Roqueloreno/ECC/presepio/3mf/PRESEPIO_v2_LED_placas.png

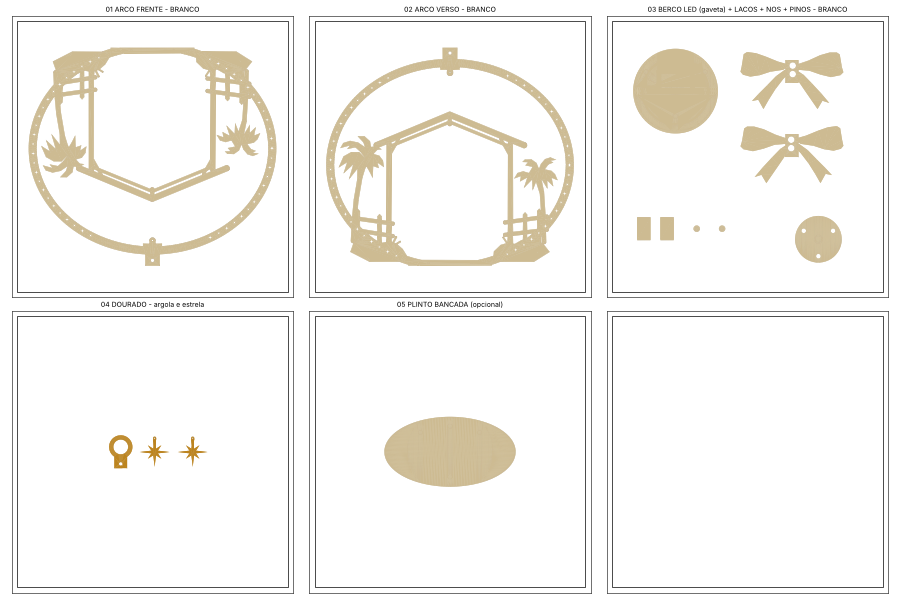
presepio/3mf/PRESEPIO_v2_LED_placas.png
