Roqueloreno/ECC/presepio/img/berco_cortes.png

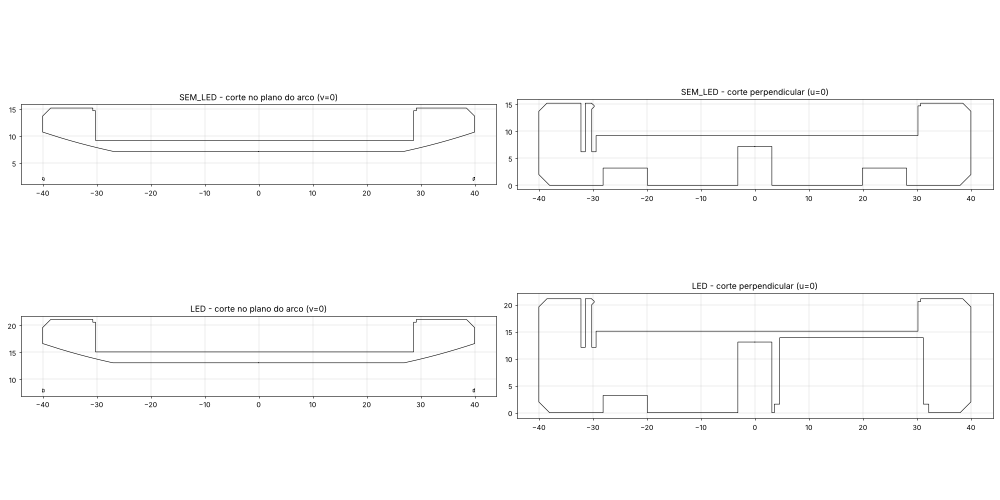
presepio/img/berco_cortes.png
