Roqueloreno/ECC/presepio/img/berco_led_fundo.png

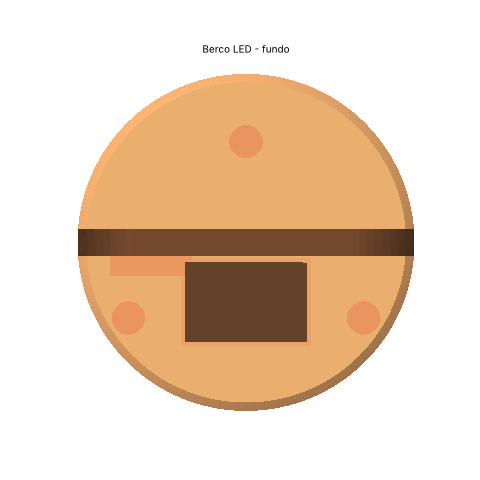
presepio/img/berco_led_fundo.png
