Roqueloreno/ECC/presepio/img/berco_led_gaveta.png

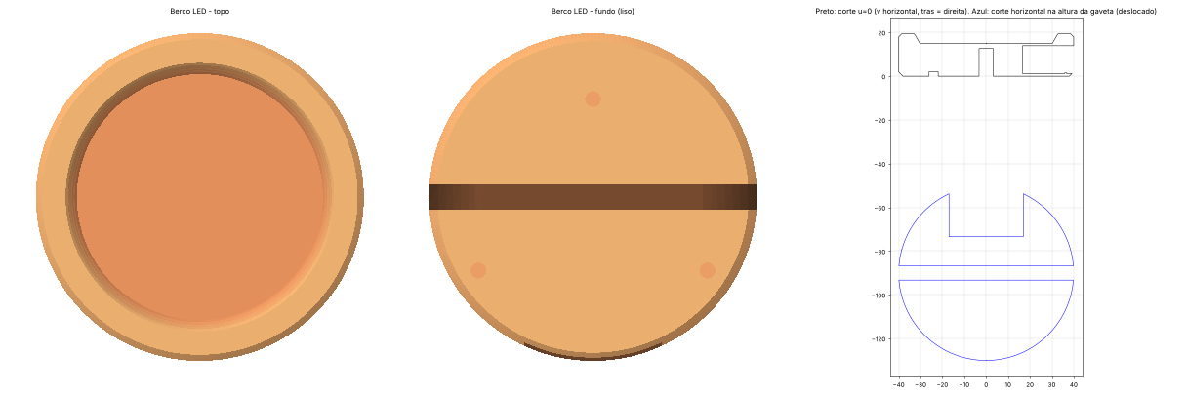
presepio/img/berco_led_gaveta.png
