Roqueloreno/ECC/presepio/img/detalhes.png

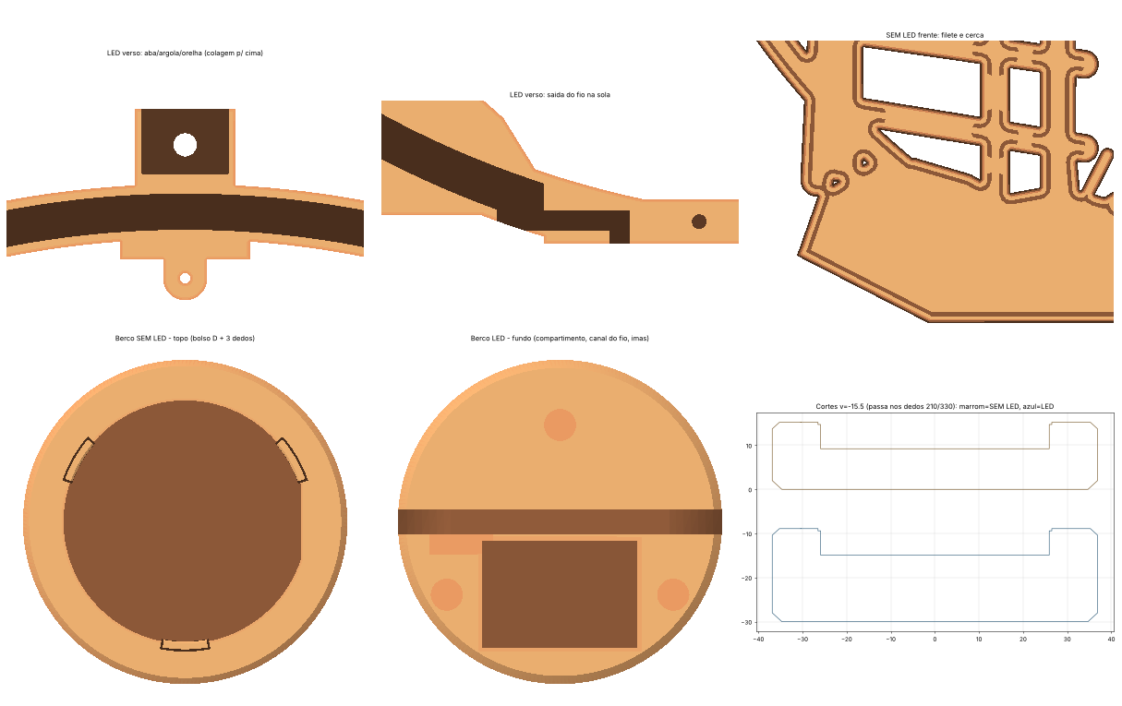
presepio/img/detalhes.png
