Roqueloreno/ECC/presepio/img/metades.png

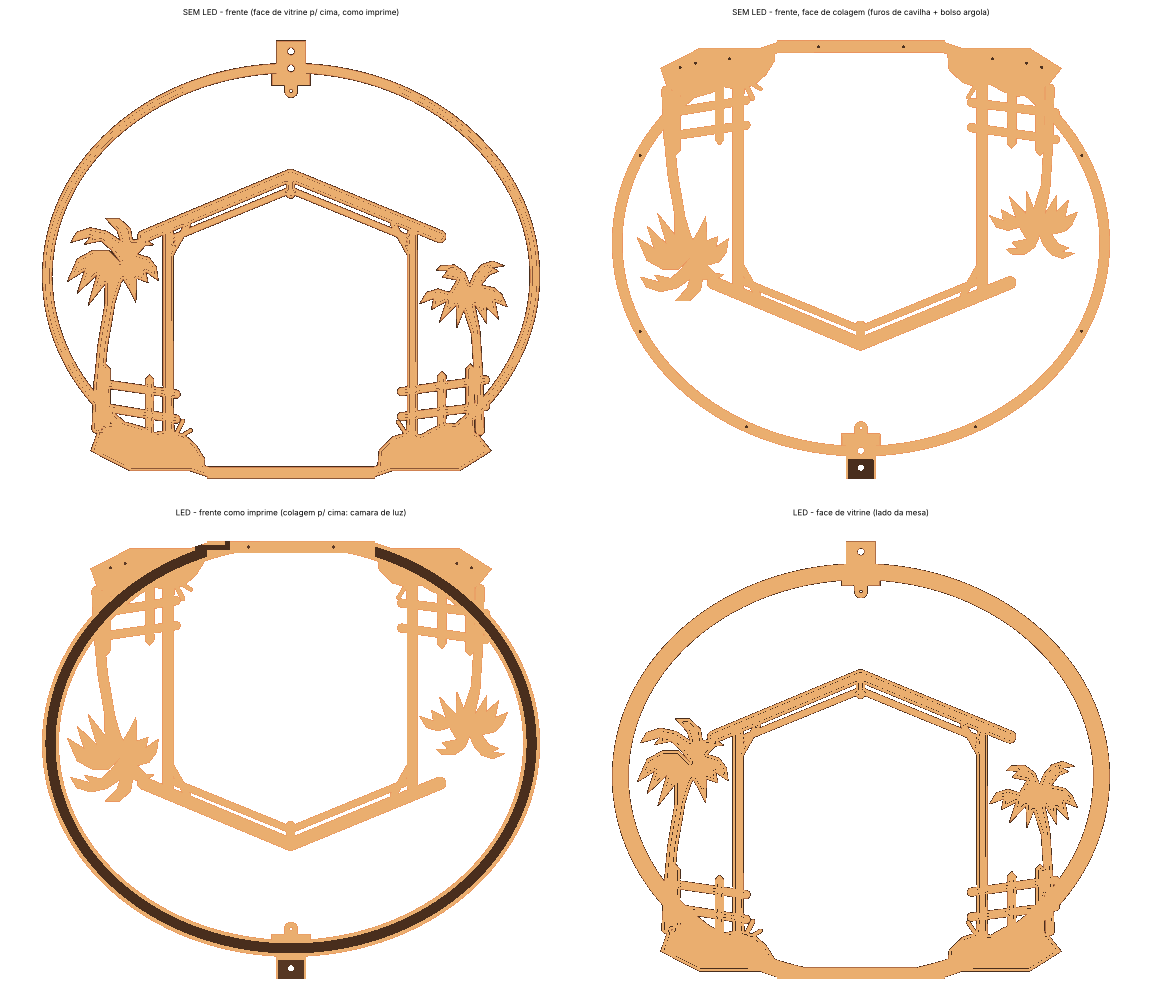
presepio/img/metades.png
