Roqueloreno/ECC/presepio/img/MONTADO_led.png

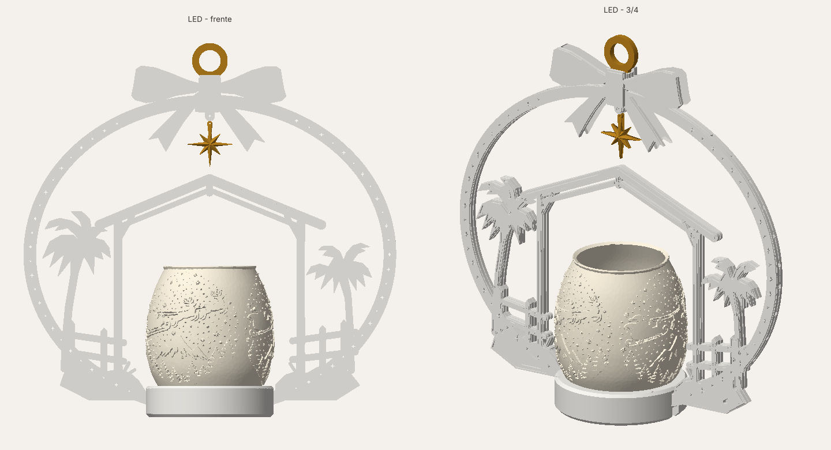
presepio/img/MONTADO_led.png
