Roqueloreno/ECC/presepio/img/MONTADO_sem_led.png

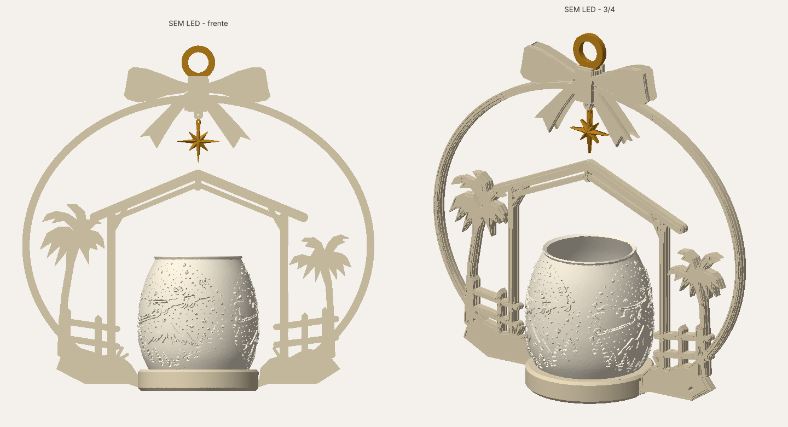
presepio/img/MONTADO_sem_led.png
