Roqueloreno/ECC/presepio/3mf/PRESEPIO_v2_SEM_LED.3mf

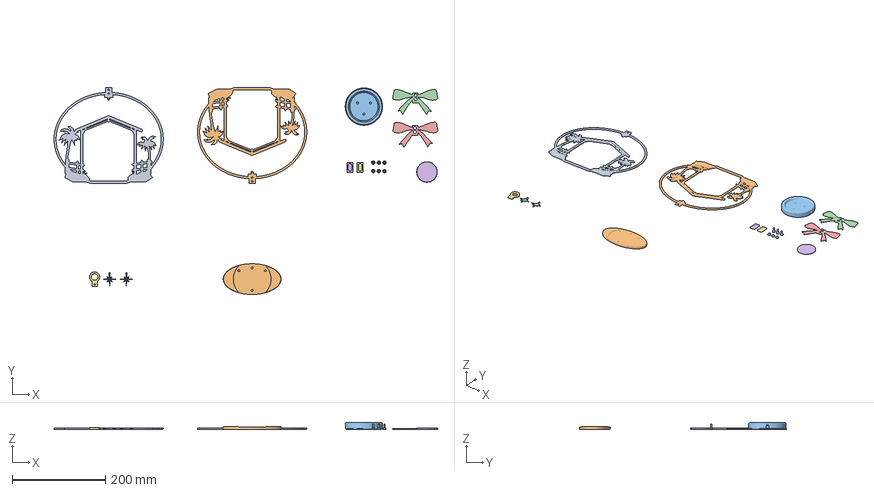
[picture p11: CAD file, 2026-10-08]
presepio/3mf/PRESEPIO_v2_SEM_LED.3mf
822.0 x 443.2 x 14.0 mm
ARCO_FRENTE
ARCO_VERSO
BERCO_COPO
LACO_FRENTE
LACO_VERSO
NO_LACO_1
NO_LACO_2
PINO_LACO_1
PINO_LACO_2
PINO_LACO_reserva
FEMEA_LACO_1
FEMEA_LACO_2
FEMEA_LACO_reserva
DISCO_PORTA_IMAS_COPO
ARGOLA_DOURADA
ESTRELA_FRENTE
ESTRELA_VERSO
PLINTO_opcional
