Roqueloreno/ECC/presepio/montagem/LED_berco.stl

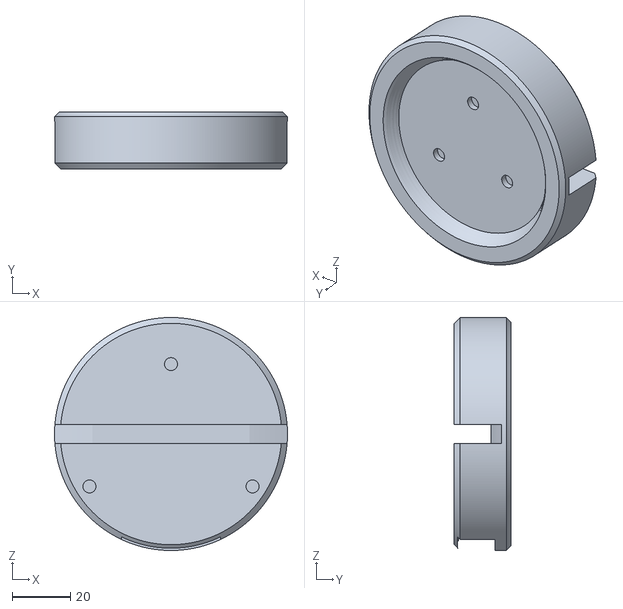
[picture p12: CAD file, 2026-10-08]
presepio/montagem/LED_berco.stl
80.0 x 19.4 x 80.0
