Roqueloreno/ECC/presepio/stl/COMUM_DISCO_PORTA_IMAS_COPO.stl

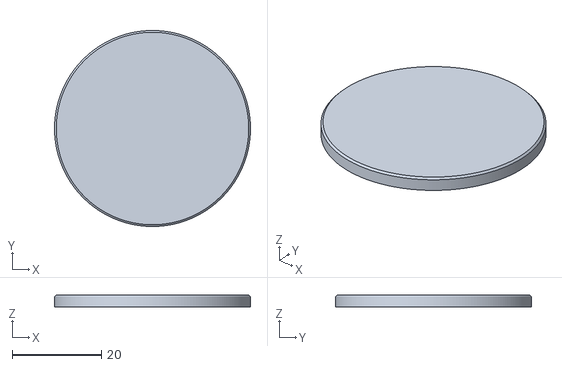
[picture p13: CAD file, 2026-10-08]
presepio/stl/COMUM_DISCO_PORTA_IMAS_COPO.stl
44.0 x 44.0 x 2.79
