Roqueloreno/ECC/presepio/teste_canal_luz_A.stl

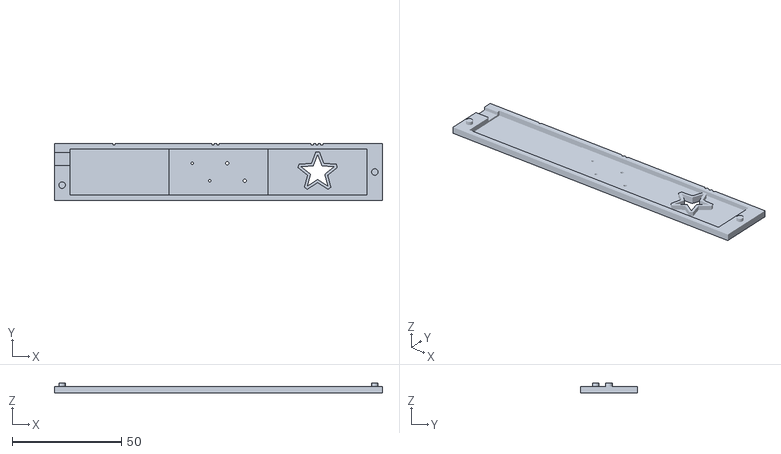
[picture p14: CAD file, 2026-10-07]
presepio/teste_canal_luz_A.stl
150.0 x 26.0 x 4.50
