Roqueloreno/ECC/presepio/3mf/PRESEPIO_v2_TESTES.3mf

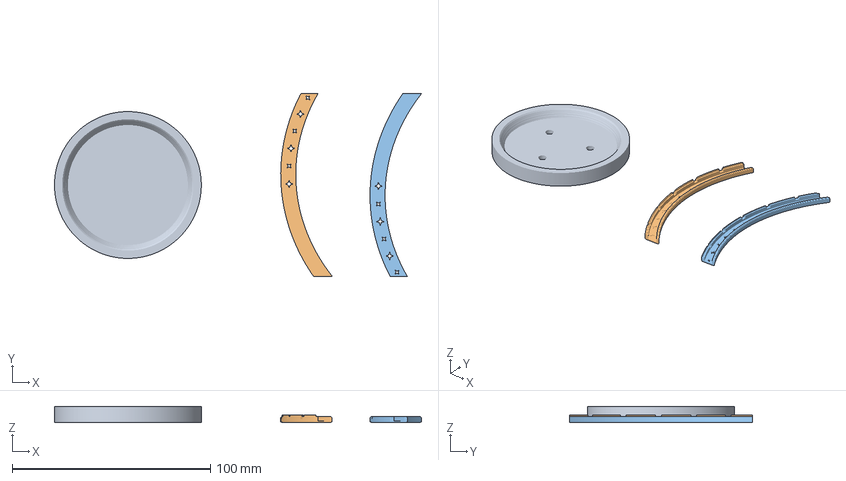
[picture p15: CAD file, 2026-10-08]
presepio/3mf/PRESEPIO_v2_TESTES.3mf
185.0 x 92.0 x 8.19 mm
TESTE_ASSENTO_COPO
TESTE_LUZ_FRENTE
TESTE_LUZ_VERSO
