Roqueloreno/ECC/presepio/montagem/SEM_LED_berco.stl

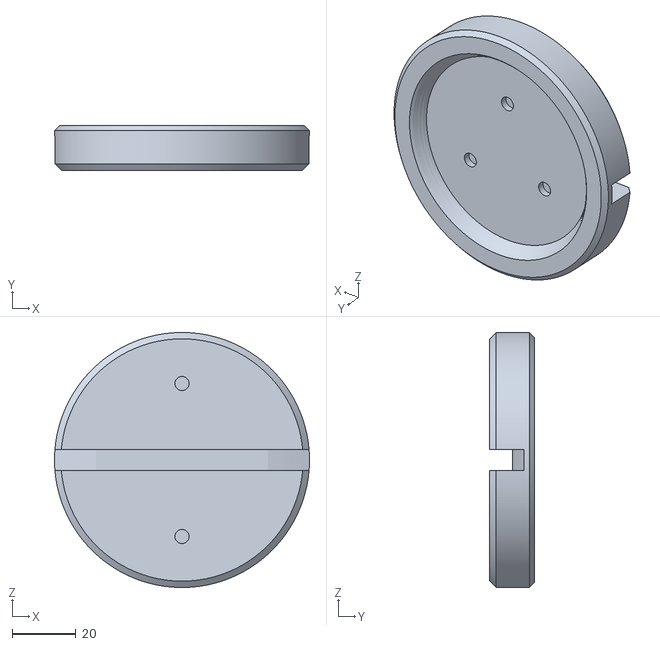
[picture p16: CAD file, 2026-10-08]
presepio/montagem/SEM_LED_berco.stl
80.0 x 14.0 x 80.0
