Roqueloreno/ECC/presepio/stl/COMUM_PINO_LACO_MACHO.stl

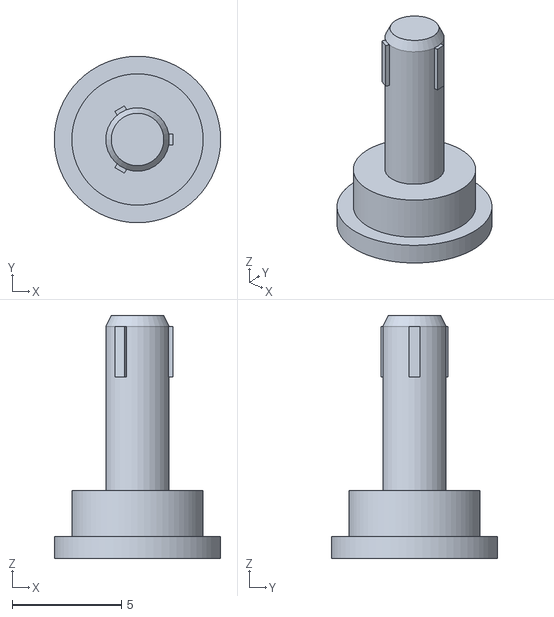
[picture p17: CAD file, 2026-10-08]
presepio/stl/COMUM_PINO_LACO_MACHO.stl
7.60 x 7.60 x 11.1
