Roqueloreno/ECC/presepio/teste_canal_luz_B.stl

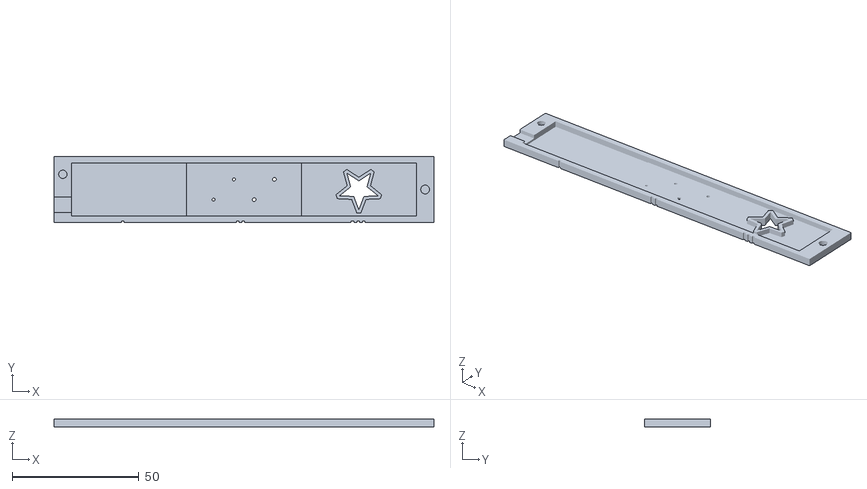
[picture p18: CAD file, 2026-10-07]
presepio/teste_canal_luz_B.stl
150.0 x 26.0 x 3.00
