Roqueloreno/ECC/presepio/montagem/LED_arco_frente.stl

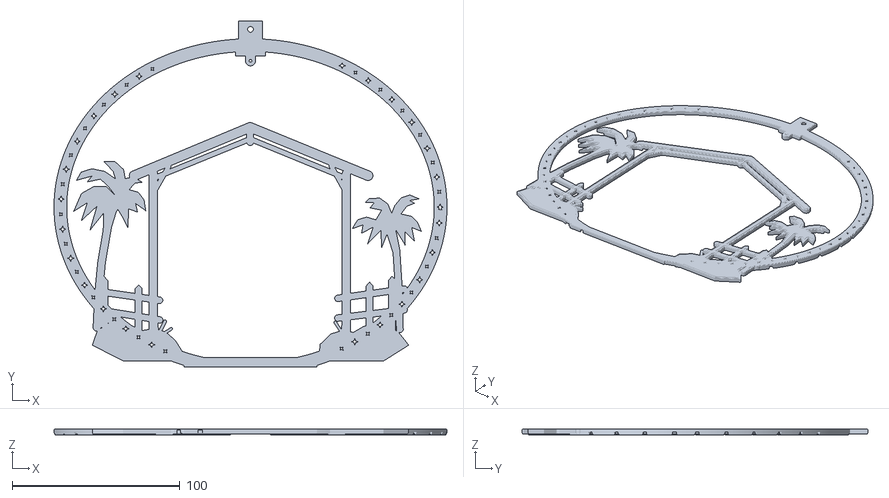
[picture p20: CAD file, 2026-10-08]
presepio/montagem/LED_arco_frente.stl
234.0 x 206.0 x 3.80
