Roqueloreno/ECC/presepio/stl/COMUM_NO_LACO_v2_imprimir_2x.stl

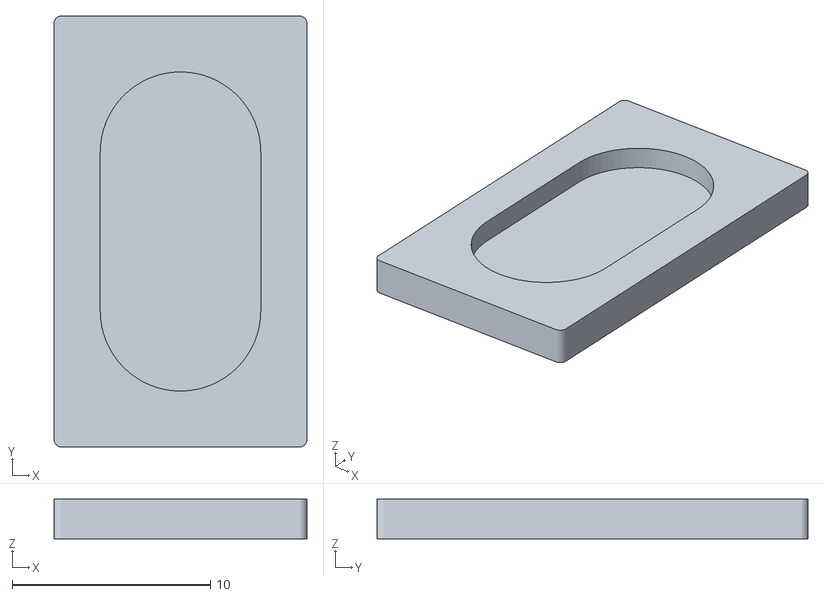
[picture p21: CAD file, 2026-10-08]
presepio/stl/COMUM_NO_LACO_v2_imprimir_2x.stl
12.8 x 21.7 x 2.00
