Roqueloreno/ECC/presepio/montagem/SEM_LED_arco_frente.stl

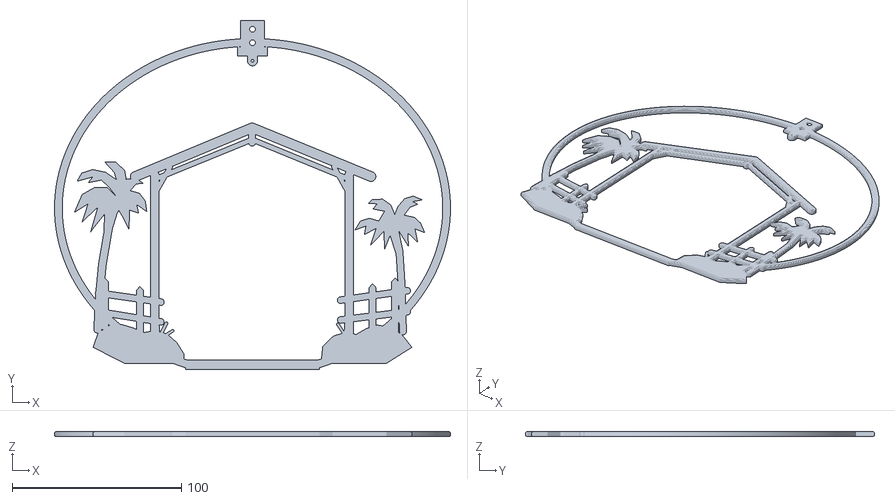
[picture p22: CAD file, 2026-10-08]
presepio/montagem/SEM_LED_arco_frente.stl
234.0 x 206.0 x 3.00
