Roqueloreno/ECC/presepio/stl/COMUM_PINO_LACO_FEMEA.stl

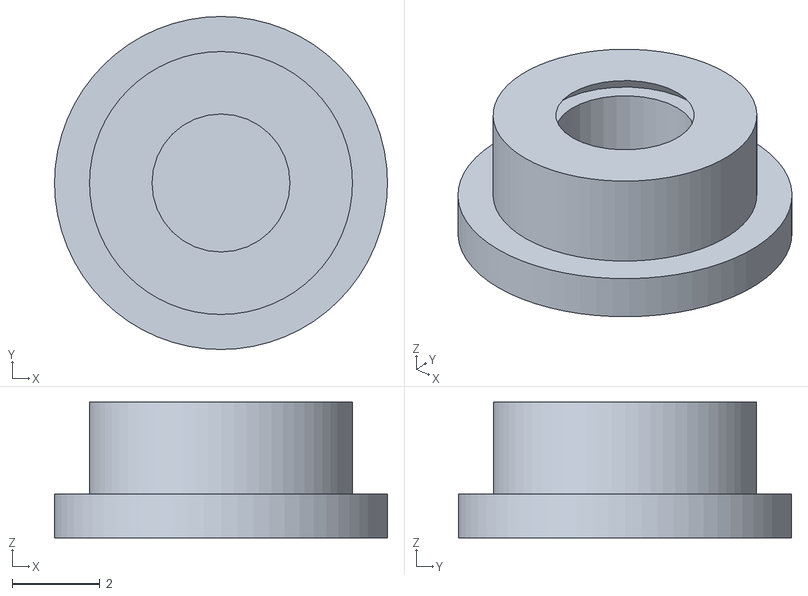
[picture p23: CAD file, 2026-10-08]
presepio/stl/COMUM_PINO_LACO_FEMEA.stl
7.60 x 7.60 x 3.10
