Roqueloreno/ECC/presepio/montagem/LED_arco_verso.stl

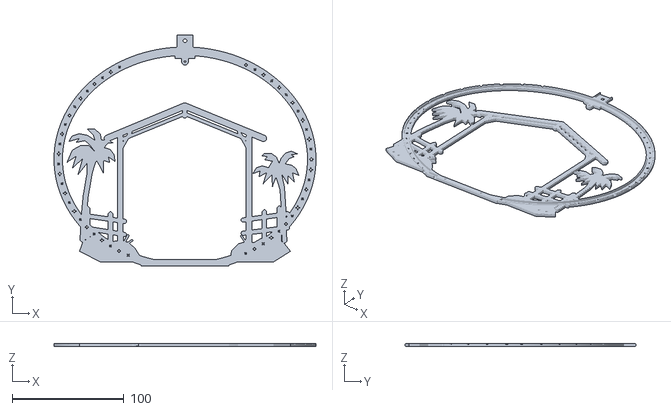
[picture p24: CAD file, 2026-10-08]
presepio/montagem/LED_arco_verso.stl
234.0 x 206.0 x 3.00
