Roqueloreno/ECC/presepio/stl/TESTE_ASSENTO_COPO.stl

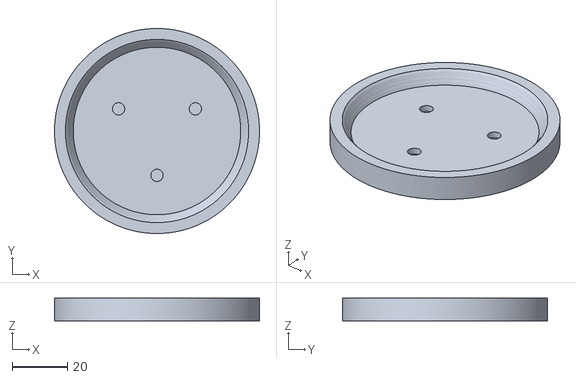
[picture p25: CAD file, 2026-10-08]
presepio/stl/TESTE_ASSENTO_COPO.stl
74.0 x 74.0 x 8.19
