Roqueloreno/ECC/presepio/stl/COMUM_PLINTO_BANCADA_opcional.stl

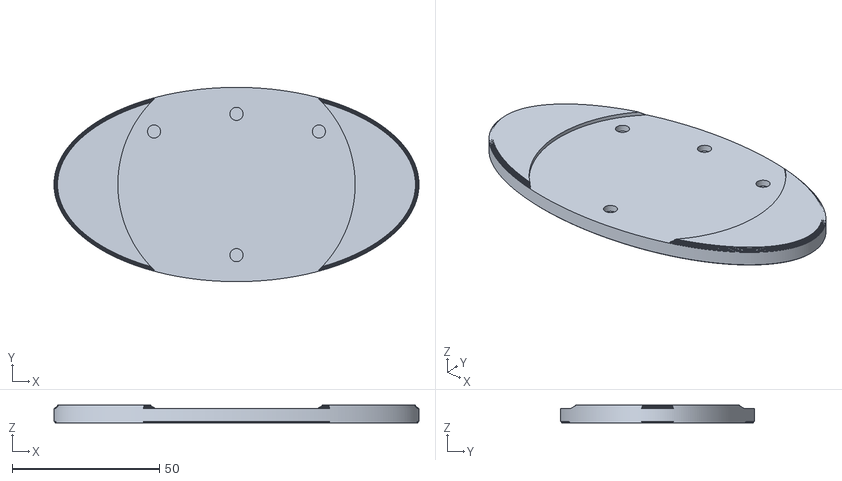
[picture p26: CAD file, 2026-10-08]
presepio/stl/COMUM_PLINTO_BANCADA_opcional.stl
124.0 x 66.0 x 6.00
