Roqueloreno/ECC/presepio/stl/TESTE_LUZ_SEGMENTO_VERSO.stl

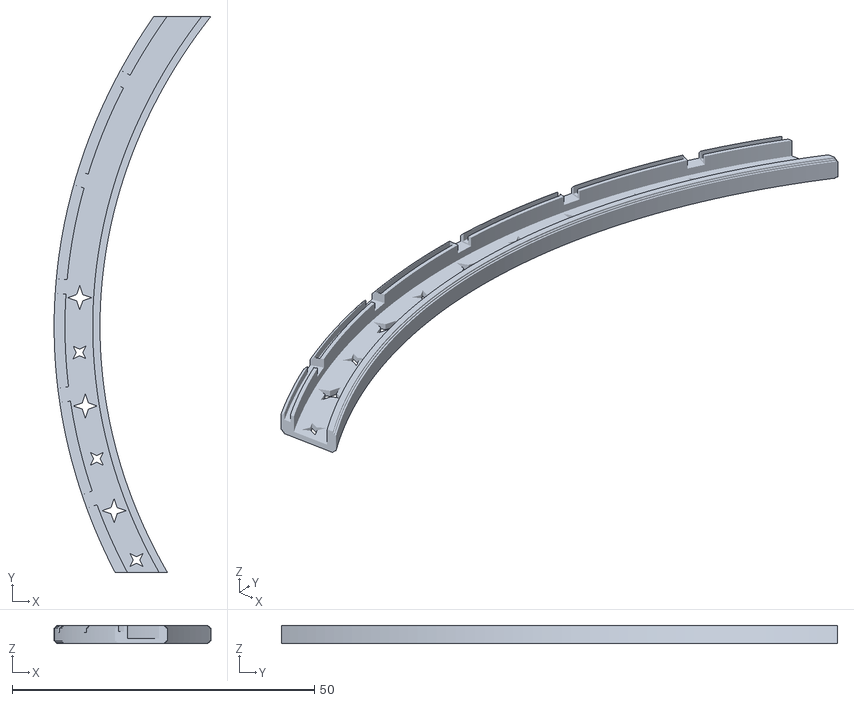
[picture p27: CAD file, 2026-10-08]
presepio/stl/TESTE_LUZ_SEGMENTO_VERSO.stl
25.9 x 92.0 x 3.00
