Roqueloreno/ECC/presepio/stl/TESTE_LUZ_SEGMENTO_FRENTE.stl

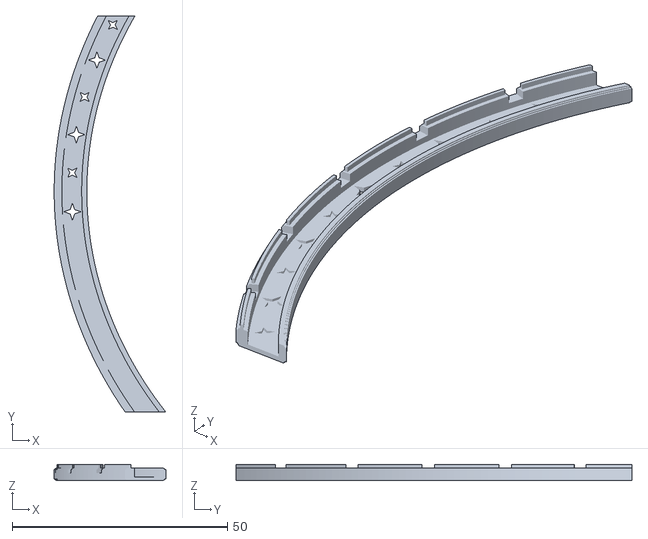
[picture p28: CAD file, 2026-10-08]
presepio/stl/TESTE_LUZ_SEGMENTO_FRENTE.stl
25.9 x 92.0 x 3.80
