Roqueloreno/ECC/presepio/stl/COMUM_ARGOLA_DOURADA_v2.stl

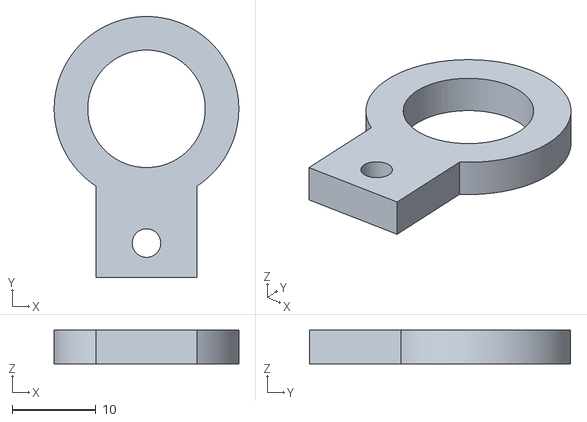
[picture p29: CAD file, 2026-10-07]
presepio/stl/COMUM_ARGOLA_DOURADA_v2.stl
22.0 x 31.1 x 4.00
