Roqueloreno/ECC/presepio/stl/COMUM_LACO_VERSO_original.stl

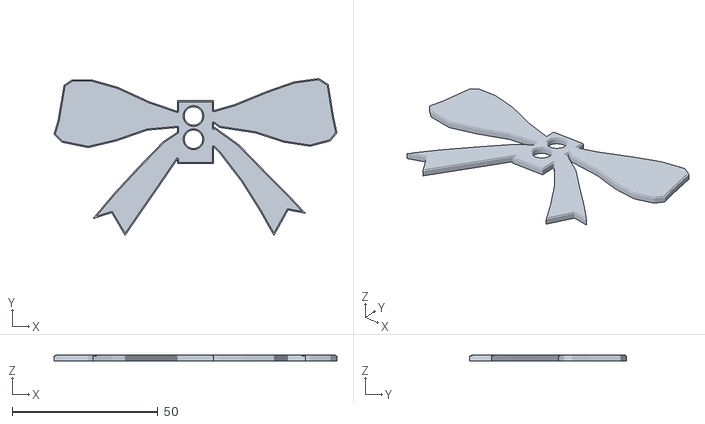
[picture p30: CAD file, 2026-10-07]
presepio/stl/COMUM_LACO_VERSO_original.stl
97.2 x 53.9 x 2.14
