Roqueloreno/ECC/presepio/stl/COMUM_NO_LACO_original_imprimir_2x.stl

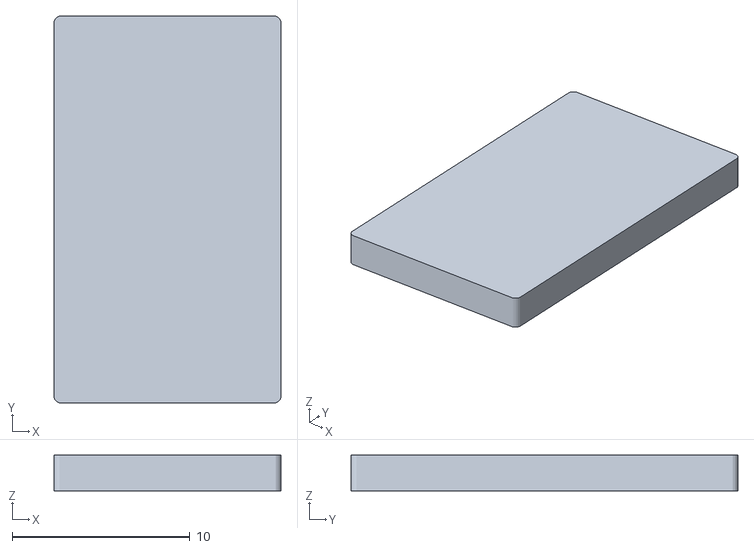
[picture p31: CAD file, 2026-10-07]
presepio/stl/COMUM_NO_LACO_original_imprimir_2x.stl
12.8 x 21.7 x 2.00
