Roqueloreno/ECC/presepio/stl/COMUM_ESTRELA_VERSO_original.stl

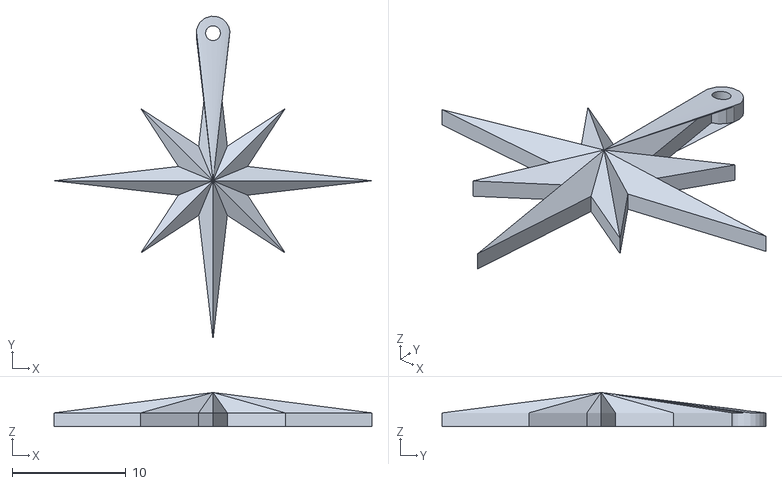
[picture p32: CAD file, 2026-10-07]
presepio/stl/COMUM_ESTRELA_VERSO_original.stl
28.0 x 28.5 x 3.00
