Roqueloreno/ECC/(list of files, cad)

Other CAD files:
presepio/montagem/SEM_LED_arco_verso.stl
presepio/stl/SEM_LED_02_BERCO_COPO.stl
presepio/stl/LED_02_BERCO_COPO.stl
presepio/stl/LED_01_ARCO_VERSO.stl
presepio/stl/LED_01_ARCO_FRENTE.stl
presepio/stl/SEM_LED_01_ARCO_VERSO.stl
presepio/stl/SEM_LED_01_ARCO_FRENTE.stl
presepio/stl/COMUM_LACO_FRENTE_original.stl
presepio/stl/COMUM_ESTRELA_FRENTE_original.stl
