Roqueloreno/ECC/presepio/img/MONTAGEM_GUIA.png

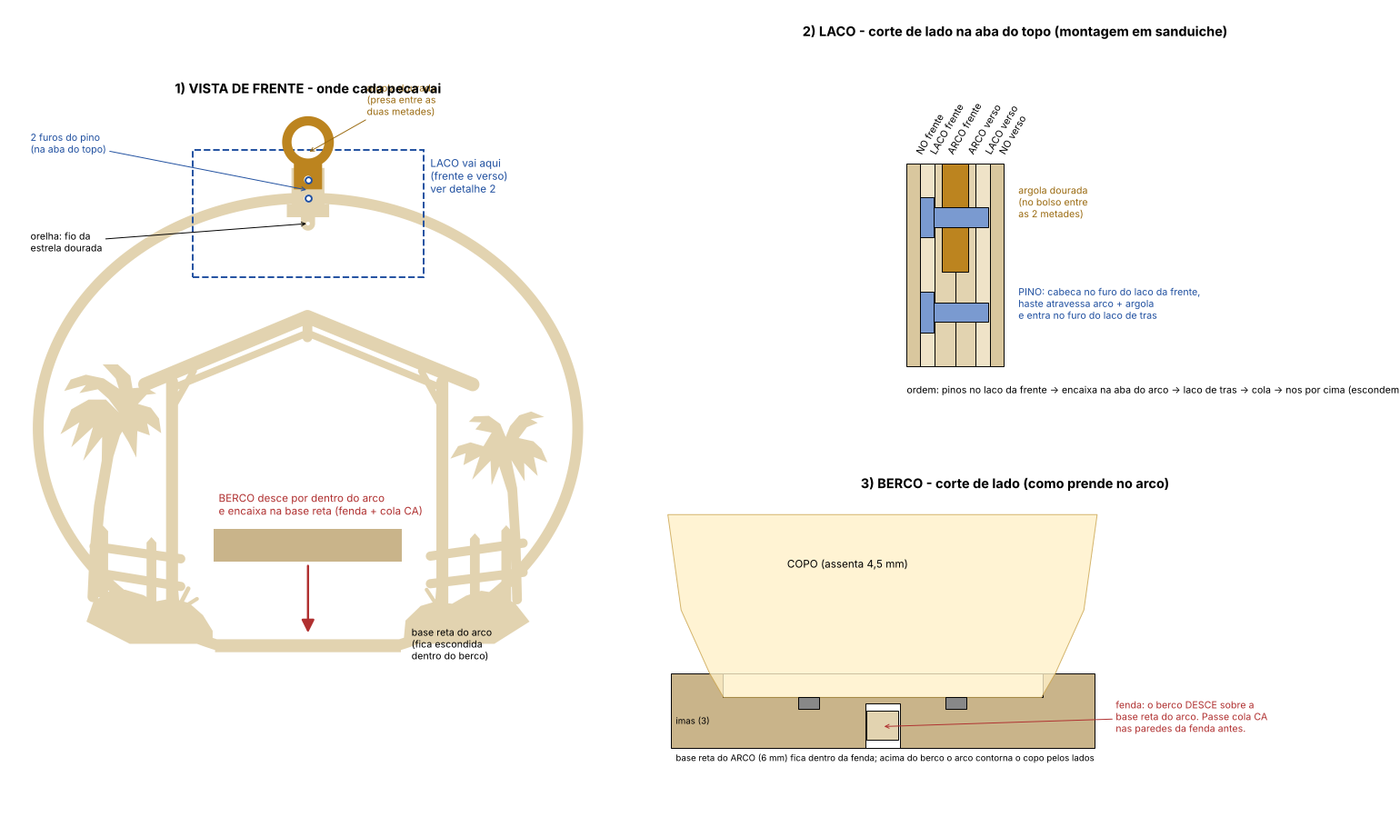
presepio/img/MONTAGEM_GUIA.png
