Roqueloreno/ECC/presepio/teste_canal_luz_preview.png

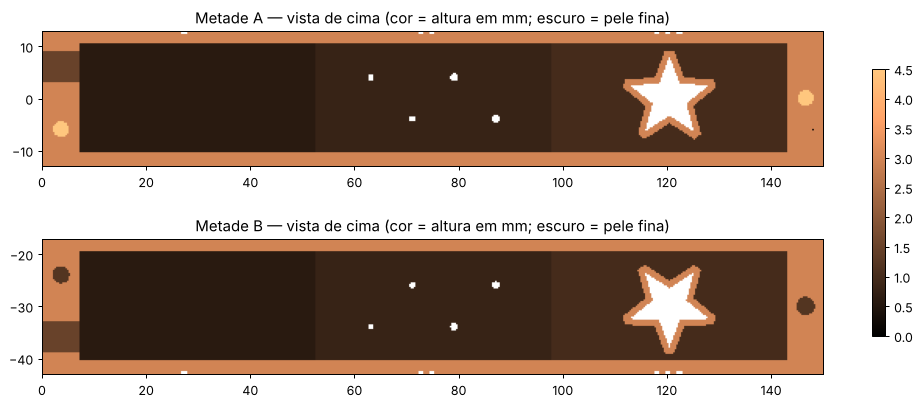
presepio/teste_canal_luz_preview.png
