Roqueloreno/ECC/(commit log)

2026-10-07 feat: add light-channel test coupon for presepio arc
    Claude-Session: https://claude.ai/code/session_01QXVeeXZ6W5GVwmVcc4kMu1
    [teste_canal_luz_A.stl, teste_canal_luz_B.stl]
2026-10-07 feat: add presepio arc v2 (LED and non-LED) generator, STLs and guide
    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
    [COMUM_ARGOLA_DOURADA_v2.stl, COMUM_ESTRELA_FRENTE_original.stl, COMUM_ESTRELA_VERSO_original.stl, COMUM_LACO_FRENTE_original.stl, COMUM_LACO_VERSO_original.stl, COMUM_NO_LACO_original_imprimir_2x.stl, COMUM_PINO_LACO.stl, COMUM_PLINTO_BANCADA_opcional.stl]
2026-10-07 feat: add Bambu Studio multi-plate 3MF projects for presepio arc v2
    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
    [PRESEPIO_v2_LED.3mf, PRESEPIO_v2_SEM_LED.3mf]
2026-10-07 feat: presepio arc rev2 - cone seat for new cup, magnets, light stars and edge windows, 0.25 clearances
    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
    [COMUM_PINO_LACO.stl, LED_01_ARCO_FRENTE.stl, LED_01_ARCO_VERSO.stl, LED_02_BERCO_COPO.stl, PRESEPIO_v2_LED.3mf, PRESEPIO_v2_SEM_LED.3mf, SEM_LED_01_ARCO_FRENTE.stl, SEM_LED_01_ARCO_VERSO.stl]
2026-10-07 fix: presepio seat for cup at file scale (80.9x80.9x80), magnets optional
    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
    [LED_02_BERCO_COPO.stl, PRESEPIO_v2_LED.3mf, PRESEPIO_v2_SEM_LED.3mf, SEM_LED_02_BERCO_COPO.stl, TESTE_ASSENTO_COPO.stl]
2026-10-07 feat: presepio LED berço sized for real battery box (28.55x18.5x12.35)
    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
    [LED_02_BERCO_COPO.stl, LED_04_TAMPA_PILHA.stl, PRESEPIO_v2_LED.3mf, PRESEPIO_v2_SEM_LED.3mf]
2026-10-07 feat: add standalone test-plate 3MF for presepio
    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
    [PRESEPIO_v2_LED.3mf, PRESEPIO_v2_SEM_LED.3mf, PRESEPIO_v2_TESTES.3mf]
2026-10-07 fix: light test segment keeps only the ring (no loose palm fragments)
    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
    [PRESEPIO_v2_LED.3mf, PRESEPIO_v2_SEM_LED.3mf, PRESEPIO_v2_TESTES.3mf, TESTE_LUZ_SEGMENTO_FRENTE.stl, TESTE_LUZ_SEGMENTO_VERSO.stl]
2026-10-07 feat: plinth/berço magnet pockets sized for 3.95x1.89 magnets
    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
    [COMUM_PLINTO_BANCADA_opcional.stl, LED_02_BERCO_COPO.stl, PRESEPIO_v2_LED.3mf, PRESEPIO_v2_SEM_LED.3mf, PRESEPIO_v2_TESTES.3mf, SEM_LED_02_BERCO_COPO.stl]
2026-10-07 feat: LED berço rear drawer for battery box with switch facing out; drop lid
    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
    [LED_02_BERCO_COPO.stl, LED_04_TAMPA_PILHA.stl, PRESEPIO_v2_LED.3mf, PRESEPIO_v2_SEM_LED.3mf, PRESEPIO_v2_TESTES.3mf]
2026-10-07 fix: merge vertices when writing 3MF (Bambu reported non-manifold edges / empty first layer)
    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
    [PRESEPIO_v2_LED.3mf, PRESEPIO_v2_SEM_LED.3mf, PRESEPIO_v2_TESTES.3mf]
2026-10-08 feat: LED arc half rib/groove alignment, 3 cup/seat magnet pairs (inside cup floor)
    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
    [LED_01_ARCO_FRENTE.stl, LED_01_ARCO_VERSO.stl, LED_02_BERCO_COPO.stl, PRESEPIO_v2_LED.3mf, PRESEPIO_v2_SEM_LED.3mf, PRESEPIO_v2_TESTES.3mf, SEM_LED_02_BERCO_COPO.stl, TESTE_ASSENTO_COPO.stl]
2026-10-08 feat: presepio final release - through stars, white filament for LED, final 3MFs without test plate
    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
    [LED_01_ARCO_FRENTE.stl, LED_01_ARCO_VERSO.stl, PRESEPIO_v2_LED.3mf, PRESEPIO_v2_SEM_LED.3mf, PRESEPIO_v2_TESTES.3mf]
2026-10-08 feat: add cup magnet-placement jig to berço plate
    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
    [COMUM_GABARITO_IMAS_COPO.stl, PRESEPIO_v2_LED.3mf, PRESEPIO_v2_SEM_LED.3mf, PRESEPIO_v2_TESTES.3mf]
2026-10-08 fix: set skin/skeleton infill line width in mm (Bambu rejected 100%)
    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
    [PRESEPIO_v2_LED.3mf, PRESEPIO_v2_SEM_LED.3mf, PRESEPIO_v2_TESTES.3mf]
2026-10-08 docs: add presepio assembly guide diagram
    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
2026-10-08 docs: assembled renders of presepio (with/without LED) and assembly-position meshes
    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
    [LED_arco_frente.stl, LED_arco_verso.stl, LED_berco.stl, PRESEPIO_v2_LED.3mf, PRESEPIO_v2_SEM_LED.3mf, PRESEPIO_v2_TESTES.3mf, SEM_LED_arco_frente.stl, SEM_LED_arco_verso.stl]
2026-10-08 fix: magnet pockets 0.25 mm radial clearance (magnets did not fit)
    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
    [COMUM_PLINTO_BANCADA_opcional.stl, LED_02_BERCO_COPO.stl, LED_berco.stl, PRESEPIO_v2_LED.3mf, PRESEPIO_v2_SEM_LED.3mf, PRESEPIO_v2_TESTES.3mf, SEM_LED_02_BERCO_COPO.stl, SEM_LED_berco.stl]
2026-10-08 feat: laço rivet (male/female pins with crush ribs) and recessed knots
    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
    [COMUM_NO_LACO_v2_imprimir_2x.stl, COMUM_PINO_LACO.stl, COMUM_PINO_LACO_FEMEA.stl, COMUM_PINO_LACO_MACHO.stl, PRESEPIO_v2_LED.3mf, PRESEPIO_v2_SEM_LED.3mf, PRESEPIO_v2_TESTES.3mf]
2026-10-08 fix: permanent magnet-holder disc inside cup so the LED tealight sits flat
    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
    [COMUM_DISCO_PORTA_IMAS_COPO.stl, COMUM_GABARITO_IMAS_COPO.stl, PRESEPIO_v2_LED.3mf, PRESEPIO_v2_SEM_LED.3mf, PRESEPIO_v2_TESTES.3mf]
